thexeno/tt08-rgbw-controller/test/stm32/ice40_rgbw_lamp_controller_bl475/Core/Src/main.c

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
/* Includes ------------------------------------------------------------------*/
#include "main.h"

/* USER CODE BEGIN PTD */

/* Define disponibili al sistema */

#define LAMP_DATA_START_POS 0
#define LAMP_DATA_W_POS (5-1)
#define LAMP_DATA_R_POS (2-1)
#define LAMP_DATA_G_POS (3-1)
#define LAMP_DATA_B_POS (4-1)
#define LAMP_DATA_BLOCK_IFC_POS (1-1)
#define LAMP_DATA_LINT_POS (6-1)
#define LAMP_DATA_RES_0_POS (7-1)
#define LAMP_DATA_RES_1_POS (8-1)
#define LAMP_DATA_END_POS 9
#define LAMP_DATA_ADC_COLOR_SLOT 42 // the answer to everything
#define LAMP_DATA_MAX_LINT 255
#define LAMP_DATA_MAX_WHITE 255

#define LAMP_DATA_ADC_CONST 4
#define LAMP_DATA_ADC_THR 2
#define LAMP_DATA_MAX_PWM 255
//#define ADC_THR_N -4

#define LAMP_TERM_FLAG_START_CHAR 0x24 //ascii $
#define LAMP_TERM_FLAG_STOP_CHAR 0x23 //ascii #
#define LAMP_TERM_CMD_MAX_LEN 10
#define LAMP_TERM_MARKER_CHAR 0x2E // ascii .
#define LAMP_TERM_PAYLOAD_LEN (10-1)
#define LAMP_TERM_BUFF_LEN (LAMP_TERM_PAYLOAD_LEN*2)-2

#define DEBOUNCE_TIME 30
#define PRESSED 0
#define NOT_PRESSED 1

/* Assgnazione bottoni */
#define  BUTTON_MAIN 0
//#define BUTTON_INCREMENT_LIGHT 0
//#define BUTTON_DECREMENT_LIGHT 1
#define TOTAL_BUTTONS 1

// Gestione analogiche
#define VUSB 1
#define VMAIN 0

#define cbi(sfr, bit) (_SFR_BYTE(sfr) &= ~_BV(bit))
#define sbi(sfr, bit) (_SFR_BYTE(sfr) |= _BV(bit))
#define ASYNC 0
#define NO_PARITY 0
#define STOP_BIT1 0
#define DATA_8BIT 0x06
#define SYSTEM_BAUD 19200

enum {
	readBtn, uartMode, readEnc, interpret, apply
};
/* USER CODE END PTD */

DFSDM_Channel_HandleTypeDef hdfsdm1_channel1;

I2C_HandleTypeDef hi2c2;

QSPI_HandleTypeDef hqspi;

SPI_HandleTypeDef hspi1;
SPI_HandleTypeDef hspi3;

UART_HandleTypeDef huart1;
UART_HandleTypeDef huart3;

PCD_HandleTypeDef hpcd_USB_OTG_FS;

/* USER CODE BEGIN PV */
static uint8_t rxComplete;
static uint8_t odd_updated = 0;
static uint16_t i;
static uint8_t rxStartLen;
uint8_t ch[1];
static uint8_t rxBuffer[LAMP_TERM_PAYLOAD_LEN], spiBuffer[8];

uint8_t btn_increment;
uint8_t btn_decrement;
uint8_t colorIndex = 0x12;
static uint8_t userMode;
static uint8_t state = readBtn;
static uint8_t mode = 0, lock = 0;

static unsigned char lamp_c2h(unsigned char msb, unsigned char lsb) {
	if ((msb < 'a' && msb > '9') || msb < '0' || msb > 'f'
			|| (lsb < 'a' && lsb > '9') || lsb < '0' || lsb > 'f') {
		// printf("Not HEX value. msb: %c, lsb: %c\n", msb, lsb);
		return 0;
	}
	if (msb >= 'a' && msb <= 'f') {
		msb = msb - 'a' + 10;
	} else {
		msb = msb - '0';
	}

	if (lsb >= 'a' && lsb <= 'f') {
		lsb = lsb - 'a' + 10;
	} else {
		lsb = lsb - '0';
	}
	return (lsb + (msb * 16));
}

static void spiFill(uint8_t id, uint8_t *data) {
	if (*data == 0x55)
		(*data)++;
	spiBuffer[id] = *data;
}

/* USER CODE END PV */

void SystemClock_Config(void);
static void MX_GPIO_Init(void);
static void MX_DFSDM1_Init(void);
static void MX_I2C2_Init(void);
static void MX_QUADSPI_Init(void);
static void MX_SPI3_Init(void);
static void MX_USART1_UART_Init(void);
static void MX_USART3_UART_Init(void);
static void MX_USB_OTG_FS_PCD_Init(void);
static void MX_SPI1_Init(void);
/* USER CODE BEGIN PFP */
uint8_t text[1];
uint8_t buffer_checker[32];
uint8_t cnt = 0;
/* USER CODE END PFP */

/* USER CODE BEGIN 0 */

void HAL_GPIO_EXTI_Callback(uint16_t GPIO_Pin) {

	if (GPIO_Pin == A0_Pin) {
		if (!lock)
			userMode = (userMode + 1);
		lock = 1;
		if (userMode == 3)
			userMode = 0;

		rxComplete = 0;
	}
	if (GPIO_Pin == A1_Pin) {
		btn_decrement = 3;
		rxComplete = 0;
	}
	if (GPIO_Pin == A2_Pin) {
		btn_increment = 3;
		rxComplete = 0;
	}

}

void HAL_UART_RxCpltCallback(UART_HandleTypeDef *huart) {

	rxBuffer[rxStartLen] = *(ch);
	HAL_UART_Receive_IT(&huart1, ch, 1);
	if (rxBuffer[rxStartLen] == LAMP_TERM_FLAG_START_CHAR) {
		rxStartLen = 0;
		odd_updated = 0;
	}

	else if ((((rxBuffer[rxStartLen] == LAMP_TERM_FLAG_STOP_CHAR)
			&& (rxStartLen == 0))
			|| (rxBuffer[rxStartLen] == LAMP_TERM_MARKER_CHAR))) {
		// Ignora il carattere
		asm("nop");

	} else if (rxBuffer[rxStartLen] == LAMP_TERM_FLAG_STOP_CHAR) {
		rxComplete = 1;
	} else {
		if (rxBuffer[rxStartLen] != LAMP_TERM_FLAG_STOP_CHAR) {
			odd_updated++;
			if (odd_updated == 2) {
				if (rxStartLen > 2) {
					asm("nop");
				}
				rxBuffer[rxStartLen - 1] = lamp_c2h(rxBuffer[rxStartLen - 1],
						rxBuffer[rxStartLen]);

				odd_updated = 0;
				rxStartLen--;
			}
			rxStartLen++;

		} else {

			rxComplete = 1;
			// no dummy read needed
			rxStartLen = 0;
		}
	}
}
/* USER CODE END 0 */

/**
  * @brief  The application entry point.
  * @retval int
  */
int main(void)
{
  /* MCU Configuration--------------------------------------------------------*/

  /* Reset of all peripherals, Initializes the Flash interface and the Systick. */
  HAL_Init();

  /* Configure the system clock */
  SystemClock_Config();

  /* Initialize all configured peripherals */
  MX_GPIO_Init();
  MX_DFSDM1_Init();
  MX_I2C2_Init();
  MX_QUADSPI_Init();
  MX_SPI3_Init();
  MX_USART1_UART_Init();
  MX_USART3_UART_Init();
  MX_USB_OTG_FS_PCD_Init();
  MX_SPI1_Init();
  /* USER CODE BEGIN 2 */
	HAL_UART_Receive_IT(&huart1, ch, 1);
  /* USER CODE END 2 */

  /* Infinite loop */
  /* USER CODE BEGIN WHILE */
	//lamp_c2h(rxBuffer[rxStartLen]);
	while (1) {

		if (rxComplete == 1) {
			// state = uartMode;
			mode = 0x21;
			mode = rxBuffer[LAMP_DATA_RES_1_POS];
			colorIndex = rxBuffer[LAMP_DATA_RES_0_POS];
			// state = interpret;
			// case interpret:

			/* 30 byte SPI lib */
			/* TX -> colorIndex, R, G, B, W, Lint, MODE(usa color index o rgbw) */
			/*RX -> niente. */
			//mode = 0xa4;
			spiBuffer[0] = 0x55;
			spiFill(1, &rxBuffer[LAMP_DATA_LINT_POS]);
			//spiFill(1, &l);
			spiFill(2, &colorIndex);
			spiFill(3, &rxBuffer[LAMP_DATA_R_POS]);
			spiFill(4, &rxBuffer[LAMP_DATA_G_POS]);
			spiFill(5, &rxBuffer[LAMP_DATA_B_POS]);
			spiFill(6, &rxBuffer[LAMP_DATA_W_POS]);
	//		spiFill(3, &r);
	//		spiFill(4, &g);
	//		spiFill(5, &b);
	//		spiFill(6, &w);
			spiFill(7, &mode);
	#if 1
			HAL_GPIO_WritePin(GPIOB, ARD_D8_Pin, GPIO_PIN_RESET);
			//for (i = 0; i <= 7; i++) {
			//SPDR = spiBuffer[i];
			HAL_SPI_Transmit(&hspi1, spiBuffer, 8, HAL_MAX_DELAY);
			//while (!(SPSR & (1 << SPIF))) {
			//	SPSR |= (1 << SPIF);
			//};
			//}
			HAL_GPIO_WritePin(GPIOB, ARD_D8_Pin, GPIO_PIN_SET);
			rxComplete = 0;
	#endif

		} else {
			if (rxComplete == 0) {
				//state = readEnc;
				switch (userMode) {
				case 0:
					//lamp_colorHandler(&sys.colorIndex, (LAMP_DATA_ADC_COLOR_SLOT*6));
					//lamp_handler(&sys.colorIndex, (LAMP_DATA_ADC_COLOR_SLOT*6));
					//  if (btn_decrement > 0 || btn_increment > 0)
					//  {
					colorIndex = colorIndex + btn_increment - btn_decrement;
					//  }

					break;

				case 1:
					//lamp_intensityHandler();
					//lamp_handler(&sys.RxBuffer[LAMP_DATA_LINT_POS], LAMP_DATA_MAX_LINT);

					rxBuffer[LAMP_DATA_LINT_POS] = (rxBuffer[LAMP_DATA_LINT_POS]
							+ btn_increment - btn_decrement);

					break;

				case 2:
					//lamp_whiteHandler();
					//lamp_handler(&sys.rxBuffer[LAMP_DATA_W_POS], LAMP_DATA_MAX_WHITE);

					rxBuffer[LAMP_DATA_W_POS] = (rxBuffer[LAMP_DATA_W_POS]
							+ btn_increment - btn_decrement);
					if (rxBuffer[LAMP_DATA_W_POS] < 7)
						rxBuffer[LAMP_DATA_W_POS] = 0;
					break;
				}
				btn_decrement = btn_increment = 0;
				mode = 0xa4;
				//state = interpret;
			}
		}

		state = readBtn;
		lock = 0;
		// break;

		// default:
		//break;
		//}
		// $00.rr.gg.bb.ww.19.00.00#
    /* USER CODE END WHILE */

    /* USER CODE BEGIN 3 */
	}
  /* USER CODE END 3 */
}

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
