thexeno/tt08-rgbw-controller/(commit log)

2024-07-18 updates pwm sync
2024-07-24 First implementation without glitch!
    Sims are ok. Needs further testing on the FPGA with the script.
    [color_gen.v, main_data_dispenser.v, rgbw_lamp.v, spi_slave.v]
2024-07-27 various optimiz di have full multiplication (this won't work, PWM broken smh)
    [color_gen.v, main_data_dispenser.v, pwm_gen.v, rgbw_lamp.v, spi_slave.v]
2024-07-28 reset fix. PWM might not have been broken. Sim ok, FPGA untested
    [rgbw_lamp.v]
2024-08-10 finals tests before integrating in tt08 flow
2024-08-12 first working TB
    SPI master data signals works.
    Now needs to be filled with use cases and assertion
2024-08-13 test update (not working correctly)
    [color_gen.v, test.py]
2024-08-13 updated reg init and reset strategy
    [color_gen.v, main_data_dispenser.v, mult8x8.v, pwm_gen.v, rgbw_lamp.v, spi_slave.v]
2024-08-15 revert back (spi slave gl test)
    [rgbw_lamp.v, test.py]
2024-08-16 Update rgbw_lamp.v
    - connter worked in main dispencer.
    - now do some actions with rdy signals and see if GDS works correctly
    [rgbw_lamp.v]
2024-08-16 Update main_data_dispenser.v
    added data transfer from spi slave to dispencer, just one byte outputted to test
2024-08-16 more bytes to test
    Added one more byte from the spi deserialization
2024-08-18 try to fix disconnected pin error
    [mult8x8.v, pwm_gen.v, spi_slave.v]
2024-08-18 add pwm and test with all
2024-08-21 correction on the buff_rx
    [main_data_dispenser.v, spi_slave.v]
2024-08-22 inserted the pwmgen (complete insertion of all modules)
2024-08-25 removing prescaler (REVERT this test)
    to check again the runs/wokwi/51-openroad-stapostpnr/max_ss_100C_1v60/checks.rpt
    [rgbw_lamp.v]
2024-08-30 spi mosi swap
2024-09-01 organizing test
    and loading the STM32 UART to SPI converter to be used by the script via UART
2025-04-07 test to trigger multiplier error
    [data_dispatcher.v]
2025-04-07 removing cause of error multiplier
    [data_dispatcher.v]
2025-04-13 (Revert manual) Max mult area, single operation
    [data_dispatcher.v]
2025-04-13 Delta resource occupation, Multipl Unit
    To be compared against the 4-tuple with the Multiplier Unit fully implemented. Just the * vs + is made. The unit, with the ready signals, must have been inserted to avoid logic optimizations
    [mult8x8.v]
2025-05-01 Revert "Delta resource occupation, Multipl Unit (further optimized)"
    This reverts commit 40a501161dffc22db8da9a12fb81cbc5cc36f300.
    [mult8x8.v]
2025-05-01 Revert "Delta resource occupation, Multipl Unit (further optimized)"
    This reverts commit 68714aad251d046df0a38bed8cb28e243c079681.
    [mult8x8.v]
2025-05-01 Reapply "Delta resource occupation, Multipl Unit (further optimized)"
    This reverts commit e087e15d1a489dfc99b1fe801e87a3c7a5609f37.
    [mult8x8.v]
2025-05-01 Reapply "Delta resource occupation, Multipl Unit (further optimized)"
    This reverts commit 151f30c27c5ca401a1fd0b980b3c8e2a76f62c6c.
    [mult8x8.v]
2025-05-01 Revert "Delta resource occupation, Multipl Unit"
    This reverts commit 8b4fdf5d792a35c15045c08105ef9bbfc6e98a8c.
    [mult8x8.v]
2025-05-01 Revert "Delta resource occupation, Multipl Unit"
    This reverts commit 14f62b380ce78d951bf1b7f353bfa7f5d610d0a2.
    [mult8x8.v]
2025-05-01 Revert "Max mult area, 4-tuple operation"
    This reverts commit 58ed84c1319c5aab013311726e634829ca4e0a1f.
    [data_dispatcher.v]
2025-05-01 Revert "(Revert manual) Max mult area, single operation"
    This reverts commit a360b310d9a99e43738e0e90b2720f8365a88b21.
    [data_dispatcher.v]
2025-05-01 Revert "Max mult area, single operation"
    This reverts commit d8947a4bec9956fd5256aaffb3fd67aa72bded2c.
    [data_dispatcher.v]
2025-05-01 Revert "removing cause of error multiplier"
    This reverts commit 4d771fc208cfe15ab610e7017833794baad4a1df.
    [data_dispatcher.v]
2025-05-01 Revert "test to trigger multiplier error"
    This reverts commit 605136832d3d44f0285beeb74db4e74a4e30e13e.
    [data_dispatcher.v]
