thexeno/tt08-rgbw-controller/(notices)

Notices in the files:
test/stm32/ice40_rgbw_lamp_controller_bl475/Core/Src/main.c:
Copyright (c) 2024 STMicroelectronics.
All rights reserved.
This software is licensed under terms that can be found in the LICENSE file
src/pwm_gen.v:
(C) Copyright 2017 Enrico Sanino
License: This project is licensed with the CERN Open Hardware Licence
v1.2. You may redistribute and modify this project under the
terms of the CERN OHL v.1.2. (http://ohwr.org/cernohl).
